freand76/TetrIC_2025/rtl/processor/processor.v

module processor(clk, n_reset,
    imem_addr_out,
    imem_data_in,
    imem_ack,
    dmem_addr_out,
    dmem_data_in,
    dmem_req,
    dmem_wr,
    dmem_ack,
    dmem_data_out,
    mfc0,
    mfc1,
    mfc2
);

    input        clk, n_reset;

    input [31:0] imem_data_in, dmem_data_in;

    output       dmem_req;
    output       dmem_wr;
    input        imem_ack, dmem_ack;
    output [23:0] imem_addr_out, dmem_addr_out;
    output [31:0] dmem_data_out;

    input  [31:0] mfc0;
    input  [31:0] mfc1;
    input  [31:0] mfc2;

    wire          n_stall, n_mem_stall;

    wire          s_if_ctrl2, s_if_imem_ack;

    wire [31:0]   s_if_pc1, s_if_pc2, s_if_pc3, s_if_pc4, s_if_pc5, s_if_pc6;
    wire [31:0]   s_if_instr, s_id_instr;

    wire [31:0]   s_id_pc1;
    wire [31:0]   s_id_data1, s_id_data2;

    wire [1:0]    s_id_ctrl_id;
    wire [7:0]    s_id_ex_ctrl;
    wire [4:0]    s_id_mem_ctrl;
    wire [2:0]    s_id_wb_ctrl;
    wire [1:0]    s_id_sel1, s_id_sel2;

    wire [15:0]   s_id_immediate;
    wire [4:0]    s_id_r1_sel, s_id_r2_sel, s_id_rd_sel;
    wire [31:0]   s_id_data3;

    wire          s_ex_n_zero;
    wire          s_ex_overflow;
    wire [4:0]    s_ex_r1_sel, s_ex_r2_sel, s_ex_rd_sel;
    wire [31:0]   s_ex_data1, s_ex_data2, s_ex_data3;
    wire [31:0]   s_ex_pc1, s_ex_pc7;
    wire [7:0]    s_ex_ex_ctrl;
    wire [4:0]    s_ex_mem_ctrl;
    wire [4:0]    s_ex_regdest;
    wire [2:0]    s_ex_wb_ctrl;
    wire [31:0]   s_ex_res;
    wire [31:0]   s_ex_alu0, s_ex_pre_alu1, s_ex_alu1;
    wire [1:0]    s_ex_sel1, s_ex_sel2;

    wire          s_mem_n_zero;
    wire          s_mem_overflow;
    wire          s_mem_ctrl2;
    wire [4:0]    s_mem_mem_ctrl;
    wire [4:0]    s_mem_regdest;
    wire [2:0]    s_mem_wb_ctrl;
    wire [31:0]   s_mem_data2, s_mem_data4;
    wire [31:0]   s_mem_pc1, s_mem_pc7;
    wire [31:0]   s_mem_res;

    wire [2:0]    s_wb_wb_ctrl;
    wire [4:0]    s_wb_regdest2;
    wire [31:0]   s_wb_data, s_wb_data4;
    wire [31:0]   s_wb_pc1;
    wire [31:0]   s_wb_res;

    mux4 fwmux1(.A(s_ex_data1),
        .B(s_wb_data),
        .C(s_mem_res),
        .D({32{1'b0}}),
        .sel(s_ex_sel1),
        .O(s_ex_alu0));

    mux4 fwmux2(.A(s_ex_data2),
        .B(s_wb_data),
        .C(s_mem_res),
        .D({32{1'b0}}),
        .sel(s_ex_sel2),
        .O(s_ex_pre_alu1));

    mux2 immux(.A(s_ex_pre_alu1),
        .B(s_ex_data3),
        .sel(s_ex_ex_ctrl[5]),
        .O(s_ex_alu1));

    alu alu(.A(s_ex_alu0),
        .B(s_ex_alu1),
        .ctrl(s_ex_ex_ctrl[4:0]),
        .O(s_ex_res),
        .n_zero(s_ex_n_zero),
        .overflow(s_ex_overflow),
        .mfc0(mfc0),
        .mfc1(mfc1),
        .mfc2(mfc2));

    mux2 pcmux1(.A(s_if_pc1),
        .B(s_if_pc6),
        .sel(s_if_ctrl1),
        .O(s_if_pc4));

    mux2 pcmux2(.A(s_if_pc4),
        .B(s_if_pc5),
        .sel(s_if_ctrl2),
        .O(s_if_pc3));

    mux2 pcmux3(.A(s_mem_pc7),
        .B(s_mem_res),
        .sel(s_mem_ctrl2),
        .O(s_if_pc6));

    assign s_if_instr = imem_data_in;

    // IF REGISTERS
    pipereg #( .WIDTH(1) ) preififreg(.clk(clk),
        .n_reset(n_reset),
        .D(imem_ack),
        .enable(1'b1),
        .Q(s_if_imem_ack));

    pipereg #( .WIDTH(32) ) pc(.clk(clk),
        .n_reset(n_reset),
        .D(s_if_pc3),
        .enable(imem_ack),
        .Q(s_if_pc2));

    // IF->ID REGISTERS
    pipereg #( .WIDTH(32) ) ifid_pc(.clk(clk),
        .n_reset(n_reset),
        .D(s_if_pc1),
        .enable(imem_ack),
        .Q(s_id_pc1));

    pipereg #( .WIDTH(32) ) ifid_instr(.clk(clk),
        .n_reset(n_reset),
        .D(s_if_instr),
        .enable(imem_ack),
        .Q(s_id_instr));

    `ifdef IVERLOG
    // simulation trace, +trace to turn it on
    reg trace_on = 0;
    initial trace_on = $test$plusargs("trace");
    always@(posedge clk)
        begin
            if (trace_on && imem_ack)
                $display("DBG PC=%x IMEM_D=%x DMEM_A=%x MEM_RA=%x MEM_DO=%x DR=%d DW=%d",
                    imem_addr_out, imem_data_in,
                    dmem_addr_out, dmem_data_in, dmem_data_out, dmem_req, dmem_wr);
        end
    `endif

    ctrl ctrl(.instr(s_id_instr),
        .ife_ctrl(s_if_ctrl2),
        .id_ctrl(s_id_ctrl_id),
        .ex_ctrl(s_id_ex_ctrl),
        .mem_ctrl(s_id_mem_ctrl),
        .wb_ctrl(s_id_wb_ctrl));

    assign s_if_pc5 = {{6{1'b0}}, s_id_instr[25:0]};

    assign s_id_r1_sel = s_id_instr[25:21];
    assign s_id_r2_sel = s_id_instr[20:16];
    assign s_id_rd_sel = s_id_instr[15:11];

    assign s_id_immediate = s_id_instr[15:0];

    signext signext(.A(s_id_immediate),
        .ctrl(s_id_ctrl_id),
        .O(s_id_data3));

    // ID->EX REGISTERS
    pipereg #( .WIDTH(32) ) ifid_pc1(.clk(clk),
        .n_reset(n_reset),
        .D(s_id_pc1),
        .enable(imem_ack),
        .Q(s_ex_pc1));

    pipereg #( .WIDTH(32) ) idex_data1(.clk(clk),
        .n_reset(n_reset),
        .D(s_id_data1),
        .enable(imem_ack),
        .Q(s_ex_data1));

    pipereg #( .WIDTH(32) ) idex_data2(.clk(clk),
        .n_reset(n_reset),
        .D(s_id_data2),
        .enable(imem_ack),
        .Q(s_ex_data2));

    pipereg #( .WIDTH(32) ) idex_data3(.clk(clk),
        .n_reset(n_reset),
        .D(s_id_data3),
        .enable(imem_ack),
        .Q(s_ex_data3));

    pipereg #( .WIDTH(5) ) idex_r1_sel(.clk(clk),
        .n_reset(n_reset),
        .D(s_id_r1_sel),
        .enable(imem_ack),
        .Q(s_ex_r1_sel));

    pipereg #( .WIDTH(5) ) idex_r2_sel(.clk(clk),
        .n_reset(n_reset),
        .D(s_id_r2_sel),
        .enable(imem_ack),
        .Q(s_ex_r2_sel));

    pipereg #( .WIDTH(5) ) idex_rd_sel(.clk(clk),
        .n_reset(n_reset),
        .D(s_id_rd_sel),
        .enable(imem_ack),
        .Q(s_ex_rd_sel));

    pipereg #( .WIDTH(5) ) idex_mem_ctrl(.clk(clk),
        .n_reset(n_reset),
        .D(s_id_mem_ctrl),
        .enable(imem_ack),
        .Q(s_ex_mem_ctrl));

    pipereg #( .WIDTH(8) ) idex_ex_ctrl(.clk(clk),
        .n_reset(n_reset),
        .D(s_id_ex_ctrl),
        .enable(imem_ack),
        .Q(s_ex_ex_ctrl));

    pipereg #( .WIDTH(3) ) idex_wb_ctrl(.clk(clk),
        .n_reset(n_reset),
        .D(s_id_wb_ctrl),
        .enable(imem_ack),
        .Q(s_ex_wb_ctrl));

    pipereg #( .WIDTH(2) ) idex_sel1(.clk(clk),
        .n_reset(n_reset),
        .D(s_id_sel1),
        .enable(imem_ack),
        .Q(s_ex_sel1));

    pipereg #( .WIDTH(2) ) idex_sel2(.clk(clk),
        .n_reset(n_reset),
        .D(s_id_sel2),
        .enable(imem_ack),
        .Q(s_ex_sel2));

    // EX->MEM REGISTERS
    pipereg #( .WIDTH(32) ) exmem_pc7(.clk(clk),
        .n_reset(n_reset),
        .D(s_ex_pc7),
        .enable(imem_ack),
        .Q(s_mem_pc7));

    pipereg #( .WIDTH(32) ) exmem_pc1(.clk(clk),
        .n_reset(n_reset),
        .D(s_ex_pc1),
        .enable(imem_ack),
        .Q(s_mem_pc1));

    pipereg #( .WIDTH(32) ) exmem_alu_res(.clk(clk),
        .n_reset(n_reset),
        .D(s_ex_res),
        .enable(imem_ack),
        .Q(s_mem_res));

    pipereg #( .WIDTH(32) ) exmem_data2(.clk(clk),
        .n_reset(n_reset),
        .D(s_ex_data2),
        .enable(imem_ack),
        .Q(s_mem_data2));

    pipereg #( .WIDTH(1) ) exmem_n_zero(.clk(clk),
        .n_reset(n_reset),
        .D(s_ex_n_zero),
        .enable(imem_ack),
        .Q(s_mem_n_zero));

    pipereg #( .WIDTH(1) ) exmem_overflow(.clk(clk),
        .n_reset(n_reset),
        .D(s_ex_overflow),
        .enable(imem_ack),
        .Q(s_mem_overflow));

    pipereg #( .WIDTH(5) ) exmem_mem_ctrl(.clk(clk),
        .n_reset(n_reset),
        .D(s_ex_mem_ctrl),
        .enable(imem_ack),
        .Q(s_mem_mem_ctrl));

    pipereg #( .WIDTH(3) ) exmem_wb_ctrl(.clk(clk),
        .n_reset(n_reset),
        .D(s_ex_wb_ctrl),
        .enable(imem_ack),
        .Q(s_mem_wb_ctrl));

    pipereg #( .WIDTH(5) ) exmem_regdest(.clk(clk),
        .n_reset(n_reset),
        .D(s_ex_regdest),
        .enable(imem_ack),
        .Q(s_mem_regdest));

    branchlogic branchlogic(.n_zero(s_mem_n_zero),
        .overflow(s_mem_overflow),
        .ctrl(s_mem_mem_ctrl[4:2]),
        .pcmux1_ctrl(s_if_ctrl1),
        .pcmux3_ctrl(s_mem_ctrl2));

    // MEM->WB REGISTERS
    pipereg #( .WIDTH(32) ) memwb_pc1(.clk(clk),
        .n_reset(n_reset),
        .D(s_mem_pc1),
        .enable(imem_ack),
        .Q(s_wb_pc1));

    pipereg #( .WIDTH(32) ) memwb_data(.clk(clk),
        .n_reset(n_reset),
        .D(s_mem_data4),
        .enable(imem_ack),
        .Q(s_wb_data4));

    pipereg #( .WIDTH(32) ) memwb_alu_res(.clk(clk),
        .n_reset(n_reset),
        .D(s_mem_res),
        .enable(imem_ack),
        .Q(s_wb_res));

    pipereg #( .WIDTH(3) ) memwb_wb_ctrl(.clk(clk),
        .n_reset(n_reset),
        .D(s_mem_wb_ctrl),
        .enable(imem_ack),
        .Q(s_wb_wb_ctrl));

    pipereg #( .WIDTH(5) ) memwb_regdest(.clk(clk),
        .n_reset(n_reset),
        .D(s_mem_regdest),
        .enable(imem_ack),
        .Q(s_wb_regdest2));

    mux4 datamux(.A(s_wb_res),
        .B(s_wb_data4),
        .C(s_wb_pc1),
        .D({32{1'b0}}),
        .sel(s_wb_wb_ctrl[2:1]),
        .O(s_wb_data));

    mux4 #( .WIDTH(5) ) regdestmux(.A(s_ex_r2_sel),
        .B(s_ex_rd_sel),
        .C(5'b11111),
        .D(5'b11111),
        .sel(s_ex_ex_ctrl[7:6]),
        .O(s_ex_regdest));

    regbank regbank(.clk(clk),
        .n_reset(n_reset),
        .r1_sel(s_id_r1_sel),
        .r2_sel(s_id_r2_sel),
        .rd_sel(s_wb_regdest2),
        .w_enable(s_wb_wb_ctrl[0]),
        .w_data(s_wb_data),
        .r1_data(s_id_data1),
        .r2_data(s_id_data2));

    fwunit fwunit(.r1_sel(s_id_r1_sel),
        .r2_sel(s_id_r2_sel),
        .mem_rd_sel(s_ex_regdest),
        .wb_rd_sel(s_mem_regdest),
        .mem_w_enable(s_ex_wb_ctrl[0]),
        .wb_w_enable(s_mem_wb_ctrl[0]),
        .sel1(s_id_sel1),
        .sel2(s_id_sel2));

    assign n_mem_stall = !(!dmem_ack & (s_mem_mem_ctrl[1] | s_mem_mem_ctrl[0]));
    assign dmem_req = s_mem_mem_ctrl[1] | s_mem_mem_ctrl[0];
    assign dmem_wr = s_mem_mem_ctrl[0];

    // PC ADD1
    assign s_if_pc1 = imem_ack ? s_if_pc2 + 1 : s_if_pc2;

    // PC ADD2
    assign s_ex_pc7 = s_ex_pc1 + s_ex_data3;

    assign s_mem_data4 = dmem_data_in;
    assign dmem_addr_out = s_mem_res[23:0];
    assign imem_addr_out = s_if_pc2[23:0];

    assign dmem_data_out = s_mem_data2;

endmodule
