freand76/TetrIC_2025/emulator/src/lib.rs

//! TetrIC emulator core: the TetrIC ASIC as built for the Tang Nano 20K
//! (rtl/), modelled closely enough to be compared with the RTL simulation.

pub mod cpu;
pub mod sound;
pub mod system;
pub mod video;
