freand76/TetrIC_2025/(commit log)

2024-09-21 Add a toplevel with a TX uart
    And synth / pnr commands for tangnano20k
2024-09-21 Read data from NVM and output on UART
2024-09-22 Read from SPI Flash to SRAM (internally in FPGA)...
    ...output to UART from SRAM
2024-09-23 Added mfc0 input register to alu
    Also connected uart_ready_tx to MFC0[0]
    Updated testcode to check for uart ready before
    transmitting next byte.
2024-09-24 Revert some failing top changes
    [processor_ram.v, top.v]
2024-09-25 Bugfix write request (dmem_wr)
    [processor.v]
2024-09-25 Processor working in tangnano20k!
    1. Copy PROGRAM from SPI FLASH to FPGA RAM (1024 instructions)
    2. Start processor and execute instructions from FPGA RAM
    - Program writes to UART
2024-09-28 Memory map the UART to all 0xfxxxxxxx addresses
2024-09-28 Print hex function i prg.s
2024-09-29 Bugfix fwunit and add all signals to ALU sensitivity list
    [alu.v, fwunit.v]
2024-09-29 print string working in prg.s
2024-09-30 Update to a simpler processor flow
    Remove stall signals and oly use imem_ack to let the
    processor continue
    [processor.v, top.v]
2024-10-06 Cleanup wires in iverilog top
2024-10-12 Clean up UART signals
2024-10-17 Bugfix DVI generator and tmds output
    [dvi_generator.v, tangnano20k_top.v, top.v]
2024-10-18 Add a white frame for the hdmitest
    To be sure the image is aligned with the display.
2024-10-19 Fix sensitivity list for signext
    [signext.v]
2024-10-20 Add video DMA
2024-10-20 Use RAM clock for video dma
2026-11-03 Run the CPU system from SDRAM (50.4 MHz)
    Connect the embedded SDRAM to the tangnano20k/src project through a
    new memory controller running on a separate 50.4 MHz PLL.
    - memory_controller: copies 1 MByte from SPI flash (0x500000) to SDRAM
    address 0 at start-up, then serves video line bursts, icache line
    bursts and processor DMEM reads/writes. One request at a time, never
    interrupted: video has top priority but cannot break an icache burst.
    - icache: 2 lines x 8 words, direct mapped, filled with 8 word bursts.
    - video/video_dma: 320x240 RGB565 frame buffer in SDRAM (packed, 160
    words per line), one burst per line into the even/odd line memories.
    Register offset 5 is the frame buffer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
2026-11-03 Python assembler with pipeline hazard checks
    - tools/abnasm.py: port of abnasm.pl (identical output), now used by
    test_code. Unknown registers are errors; nested macros work (Perl
    dropped the rest of the outer macro).
    - Pipeline hazards (missing nops) are errors; --suggest-nops and
    --remove-nops list/remove redundant nops.
    - PIPELINE_HAZARDS.md: delay slots and nop rules, verified in simulation.
    - prg.s: fix $a typo (was $zero) in two ori instructions.
2026-11-03 Video: gfxbox register set and MFC1 status
    - Registers as old_vhdl/gfxbox.vhd: TOPPOS, LEFTPOS, PIXPERLINE,
    LINEPERIMG, PIXREAD (horizontal stretch), GFXADDR, DELTAADDR.
    Applied at frame start; PAL sync registers are ignored.
    - MFC1 reads {frame, x, line}.
    - Variable length video bursts; tb checks frames against the registers.
    - test_code/video_test.s; make program-flash-code PRG=<name>.
2026-11-03 Add standalone bars demo
    Port of TetrIC/Bars.s: 7 shaded bars rotating around a middle bar,
    full width (128 px, PIXREAD 5), double buffered at exactly 30 Hz.
2026-11-03 Add PlayStation gamepad controller on MFC2
    - gamepad.v: DualShock protocol, 125 kHz, polled at 60 Hz.
    - MFC2 = {8'h00, B2, B1, joy}, active low; joy uses the old TetrIC
    bit order (old_vhdl/joyctrl.vhd, TLib/Joy.s).
    - Pins 17-20 as nand2mario's nano20k.cst; LEDs reduced to two.
    - test_code/pad_test.s: shows the buttons on screen and uart.
2026-11-03 Fix shifter sensitivity lists
    rshifter missed shift_in, so sra could use a stale sign in
    simulation. Use always @(*) in both shifters (no synthesis change).
    [lshifter.v, rshifter.v]
2026-11-04 iverilog: preload, run time, frame dump and gamepad model options
2026-11-04 Port TetrIC game to game_code
    Joystick on the PS2 pad, 30 Hz frame pacing, no bootloader.
2026-11-04 Sound unit: 8 channel sample player over HDMI audio
    Port of the old TetrIC sound box register map (effect channels 4-7).
    Samples are fetched from SDRAM through a new memory controller port;
    channel state lives in LUT RAM. Video now uses hdmi_generator.
    iverilog: make sound runs test_code/sound_test.s and checks the
    output bit exact against tools/sound_ref.py.
    Scroll text: include the whole TheText.txt (it was cut at 512 bytes)
    and fix spelling. abnasm: .file length is optional (whole file) and a
    warning is printed when a file is truncated.
    [memory_arbiter.v, memory_controller.v, sound.v, top.v, video.v]
2026-11-04 game_code: 60 Hz frame pacing, down = drop
    One game frame per HDMI frame. Frame counts scaled by 6/5 and per frame
    steps by 5/6 from the 50 Hz original; FrameCount, Tick50 and HalfStep
    keep the "every Nth frame" effects at their 50 Hz rate. Scroller at
    4 pixels per frame. Gamepad: down drops the piece, up moves it down
    (the original mapping).
2026-11-04 Sound: MOD player for channels 0-3, stand-alone sound simulation
    sound_seq.v plays the old TetrIC song format (old_vhdl/mainunit.vhd):
    it reads patterns, instrument headers, the order table and the note
    frequency table through the sound unit's memory port and drives
    channels 0-3 with the same writes as the effect channels. Per channel
    state in LUT RAM. The MOD tick follows WAITCLK in samples (+525 per
    sample). Effects 1, 2, 3, 5, 6, A, B, C, D, E1/E2/EA/EB, F.
    sound.v: END = 0 stops a channel at once; sequencer reads wait for
    the sample fetches.
    soundsim/: Verilator test bench for the sound unit alone (beat, game
    music, effects test song); tools/sound_ref.py checks the sequencer
    writes and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
2026-11-04 game_code: MOD tick 504000 clocks, louder beat, scroll text end
    WAITCLK = 25.2 MHz / 50 Hz. Beat at full volume (64). The scroll
    text ends with a space instead of a newline.
2026-11-04 Fix WB forwarding when the EX instruction does not write; digsim 1.10.0
    fwunit: forwarding from WB (distance 2) was dropped when the
    instruction in EX had the same destination register number but did not
    write a register (sw, branches): the condition had !wb_w_enable where
    old_vhdl/fwunit.vhd has memregwr = 0. The CPU then read the stale
    register, also in code the hazard checker accepts. Now !mem_w_enable,
    for both operands (the old VHDL compared rt instead of rs for sel1).
    Checked with a CPU test (addi; sw; add at distance 2): stale 100
    before, 5 now. The fwunit WB tests set mem_rd_sel instead of
    wb_rd_sel.
    Module testbenches: digsim 1.10.0 API (YosysNetlist(**netlist_dict));
    the ALU test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
    [fwunit.v]
2026-11-04 Restructure: rtl/, sim/, tangnano20k_test/; own SPI flash model
    rtl/ the system RTL (was src/top/)
    sim/models/ simulation models: spi_flash_model.v (new),
    gowin_prims.v (one model file for RAM16SDP4, rPLL,
    CLKDIV, OSER10, TLVDS_OBUF), sdram_model_burst.v,
    ps2pad_model.v
    sim/system/ full-system simulation (was iverilog/): make run,
    sound, fwd (new forwarding test), check
    sim/sound/ sound unit simulation (was soundsim/)
    sim/pytest/ digsim module testbenches, rtl_path fixture in
    conftest.py (pytest.ini testpaths)
    tangnano20k_test/ hdmi, sdram (with its own s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
    [alu.v, branchlogic.v, cdc.v, ctrl.v, dvi_generator.v, flash_reader.v, fwunit.v]
2026-11-04 Add a built bitstream: tangnano20k/bitstream/tetric.fs
    Built from the sources of d3c9453 (forwarding fix included), tested on the
    board with the game. Flash with
    openFPGALoader -btangnano20k -f tangnano20k/bitstream/tetric.fs
2026-11-04 README: background, tool install, gamepad, assembler, caveats; uv for Python
    - README: background (LTH ASIC project 2000-2001, VHDL -> Verilog
    2025-2026), screenshot, board and kit images, tool installation
    (apt, uv, Apicula, nextpnr-himbaechel, openFPGALoader with sources),
    gamepad connection with breadboard photo and pinout, quick start and
    controls, simulation, abnasm.py, 32/64-bit number caveats, processor
    delay slots / nops / immediate extension. All make targets checked.
    - Python scripts have a uv shebang with inline metadata, the Makefiles
    run them with uv run --script
    - Remove old_vhdl/ (in history up to 39a567d); RTL comments name the
    original VHDL files instead
    - tang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
2026-11-05 game_code: hazard nops only where needed, faster PrintASCII, unused macros removed
    The load/store macros (POP, PUSH, _LW, _SW, _LDA, _LDO) no longer contain
    nops; a nop is written only where the abnasm hazard checker asks for one.
    PrintASCII is branch free (ASCII_OpaqueRow / ASCII_TransRow), so the menu
    and the game run at 60 fps (was 30 fps). The unused macros li, _BGTZ and
    _JR are removed (li uses are now _LI).
    Checked in the emulator with ideal timing against the previous build:
    583 of 583 frames equal over 20 s with a played game.
2026-11-05 sim/system: Verilator game run, CPU trace, statistics, sequencer log
    - make game: the game in a Verilator build of tb_system (about 5 ms of
    game per second), +fix_beam, +swaplog, +stats (with stall cycles by
    cause), +profile, gamepad presses
    - +cputrace: register writes, stores and MFC values, for the emulator
    - +audio also logs the MOD sequencer writes and events
    - SDRAM model: Verilator tristate path, power-up on the first NOP
    - SPI flash model: $readmemh loader
    - RTL trace prints only with +trace
    [processor.v, regbank_sram.v, sdram_model_burst.v, spi_flash_model.v, tb_system.v, top.v]
2026-11-05 tools/mod2tetric.py: convert MOD songs to the TetrIC song format
    Converts 4 channel MOD files (M.K., M!K!, 4CHN, FLT4, 15 sample) to the
    format of the sound unit's MOD sequencer, with a report of dropped effects
    and a WAV preview through tools/sound_ref.py.
2026-11-05 emulator: TetrIC emulator in Rust (Linux, Windows)
    tetric_emu --flash game_code/out/TetrIC.bin: picture, sound with the MOD
    player, keyboard and USB gamepad, 60 fps. The CPU models every pipeline
    register of processor.v, so delay slots, forwarding and the hazards behave
    as on the board; video, sound, MOD sequencer, instruction cache and stall
    timing follow the RTL.
    Cross checked with the RTL simulation (rtl_check.sh): 47.8 M lines of CPU
    trace, 184 frames, 288 731 sound samples and the sequencer writes are
    equal. compare_builds.sh compares two builds of a program with ideal
    timing. README: build (Windows with cargo-zigbuild), use, model, results.
    [cpu.rs, frontend.rs, lib.rs, main.rs, sound.rs, system.rs]
2026-11-11 game_code: no 'L' on the uart for late frames
2026-11-11 README: original project team, no 'L' for late frames
